gregsell/Dieter_PEV_Simulator/README.md

# dieter for EVerest PEV simulator
The EVerest PEV Simulator project documentation is split in two repositories:
1. the EVerest software running on linux, available at [gregsell/DieterEvDriver](https://github.com/gregsell/DieterEvDriver/)
2. this repo: electronics and firmware of the "Dieter" handling low level communication - *" Device Interface ElecTronic Especially not limited to Raspberry"*

demo: https://youtu.be/5YWvrdBq7K8?si=sz70jL9PTbtog_6K  
An essay covering the whole project is available under [gregsell/DieterEvDriver/docs/](https://github.com/gregsell/DieterEvDriver/) in english and german.  

## Hardware and Firmware for the Dieter PEV Simulator Board

This board is a physical interface between the [EVerest PEV Simulator](https://github.com/gregsell/DieterEvDriver/) software running on linux and a real CCS charging station. It generates and measures the IEC 61851 Control Pilot (CP) signal, drives the contactor and plug lock, and measures current and voltage on the HV lines.
The board is designed for DC charging test setups and capable of handling very high voltages.

The name and concept come from [uhi22/dieter](https://github.com/uhi22/dieter), a hardware design by Uwe Hennig. That project uses [pyPLC](https://github.com/uhi22/pyPLC) as simulation software. This repository adapts the hardware and uses an [EVerest](https://everest.github.io)-based software stack, which takes over the protocol logic from pyPLC.

## System Overview

hadware overview

## Hardware Components

The Arduino handles all low-level I/O relevant for CCS communication:

- **CP PWM measurement**: Fixed 5% duty cycle at 1 kHz (per IEC 61851-1) signals switch to high level communication by the EVSE
- **CP state control**: Sets CP voltage level to signal current state to EVSE during low-level communication
- **Contactor control**: Closes/opens the DC contactors on command from EVerest
- **Connector lock actuator**: Engages/releases the mechanical connector lock
- **Power meter**: Measures HV voltage and current

The Arduino communicates with the linux host over UART via USB using a simple text-based protocol, as implemented in the [`DieterEvDriver`](https://github.com/gregsell/DieterEvDriver/tree/main/modules/DieterEvDriver) EVerest module.
All the logic runs on the linux host. This board simply executes its commands and reads back measurements.

### HomePlug PLC Modem

In this project a patched TPlink TL-PA4010P v5.0 used (chipset: AR7420). (In the pyPLC project several modems were tested, see https://github.com/uhi22/pyPLC/blob/master/doc/hardware.md) The necessary modification steps are available there as well.   

The modem connects to the CP line and handles the high-level communication necessary for CCS. The Linux host runs `EvSlac` (EVerest module) for SLAC matching and PyEvJosev for the V2G ISO 15118-2 session over PLC.

## Arduino Serial Protocol
The Arduino exposes a simple newline-delimited text protocol over serial. The `DieterEvDriver` EVerest module running on the linux host speaks this protocol.
```
commands (host -> MCU)
  keys                   possible values            
  set_contactor             {0, 1}                            
  set_connector_lock        {0, 1}   
  set_state_c               {0, 1}

measurements (MCU -> host)
  u_inlet                   {0, 1, 2...}
  current                   {0.0, 1.0, 2.0,..}
  cp_duty_cycle             {0, 1, ..99, 100}
  connector_lock_confirmed  {0, 1}

each newline-terminated and separated by colon.

examples:
  "set_contactor:0\n"
  "u_inlet:800\n"
```
**Notes:**
- `current` is the only `float`, all the others are `integer`
- `set_state_c` might be misleading. In general there are more states, but this is the only one the EV can signal. (B <-> C)
- EVerest itself does not need current and voltage measurements

## Mounting
Mounting everything to a DIN rail (german "Hutschiene") makes it possible to use stock parts and be flexible with arrangement.

For the single PCBs adaptors were 3d printed to work with this design: https://www.printables.com/model/161740-din-rail-clip  
The source files are available under [/docs/mounting]().

Each clip can hold up to three M3 nuts spaced 9 mm apart and can be attached (and removed!) from the rail with a screwdriver. 

---

## Related Projects and useful links

- [uhi22/dieter](https://github.com/uhi22/dieter) — Original "Dieter" hardware firmware
- [uhi22/pyPLC](https://github.com/uhi22/pyPLC) — Python PLC/V2G stack, first open-source CCS implementation, also the hardware of the original "Dieter"
- [uhi22/foccci](https://github.com/uhi22/foccci) — open-source CCS controller, developed by openinverter community, runs a port of pyPLC
- [discussion on openinverter](https://openinverter.org/forum/viewtopic.php?p=37085) — homeplug investigations, beginnings of pyPLC
- [EVerest](https://github.com/EVerest/everest-core) — EV charging framework
- [charIn CCS design guide](https://www.charin.global/media/pages/technology/ccs-specification/c07034e41e-1626949173/design_guide_combined_charging_system_v7.pdf) — very useful. (Almost) everything you ever need to know about CCS
- [open-plc-utils](https://github.com/qca/open-plc-utils) — toolkit for patching PLC modem
