gregsell/Dieter_PEV_Simulator/docs/mounting/Dieter_box_DIN_rail_adapter.step

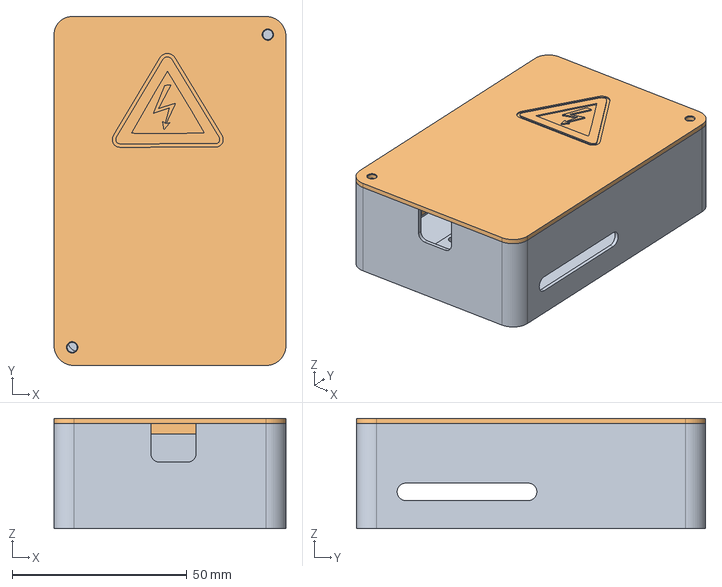
[picture p1: CAD file, 2026-06-02]
docs/mounting/Dieter_box_DIN_rail_adapter.step
66.4 x 99.9 x 31.5 mm
adapter
lid
