gregsell/Dieter_PEV_Simulator/docs/mounting/L298N_board_DIN_rail_adapter.step

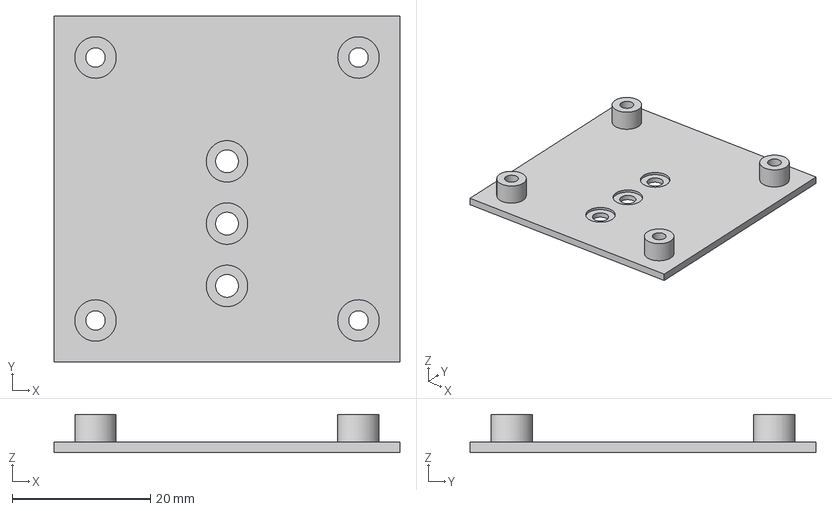
[picture p2: CAD file, 2026-06-02]
docs/mounting/L298N_board_DIN_rail_adapter.step
50.0 x 50.0 x 5.50 mm
