gregsell/Dieter_PEV_Simulator/docs/mounting/TL-PA4010P_v5.0_homeplug_adapter.step

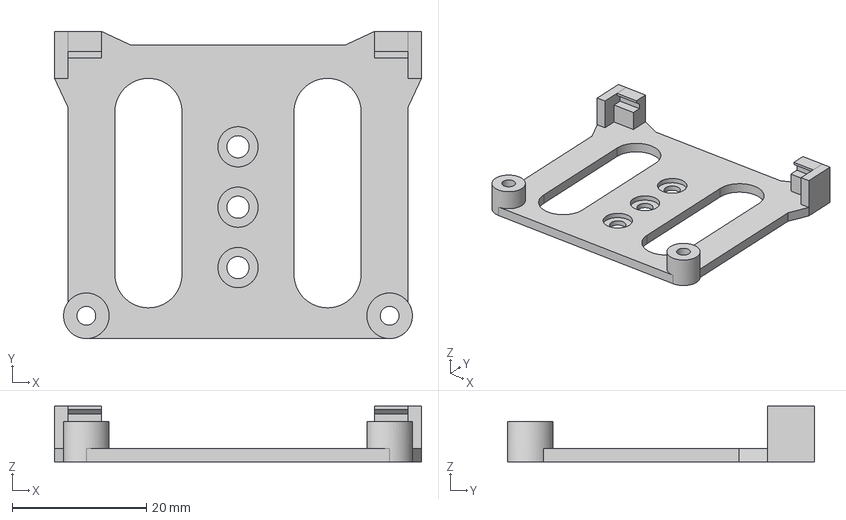
[picture p3: CAD file, 2026-06-02]
docs/mounting/TL-PA4010P_v5.0_homeplug_adapter.step
54.7 x 45.8 x 8.30 mm
