gregsell/Dieter_PEV_Simulator/docs/pcb/Dieter_PEV_Simulator_schematic.pdf

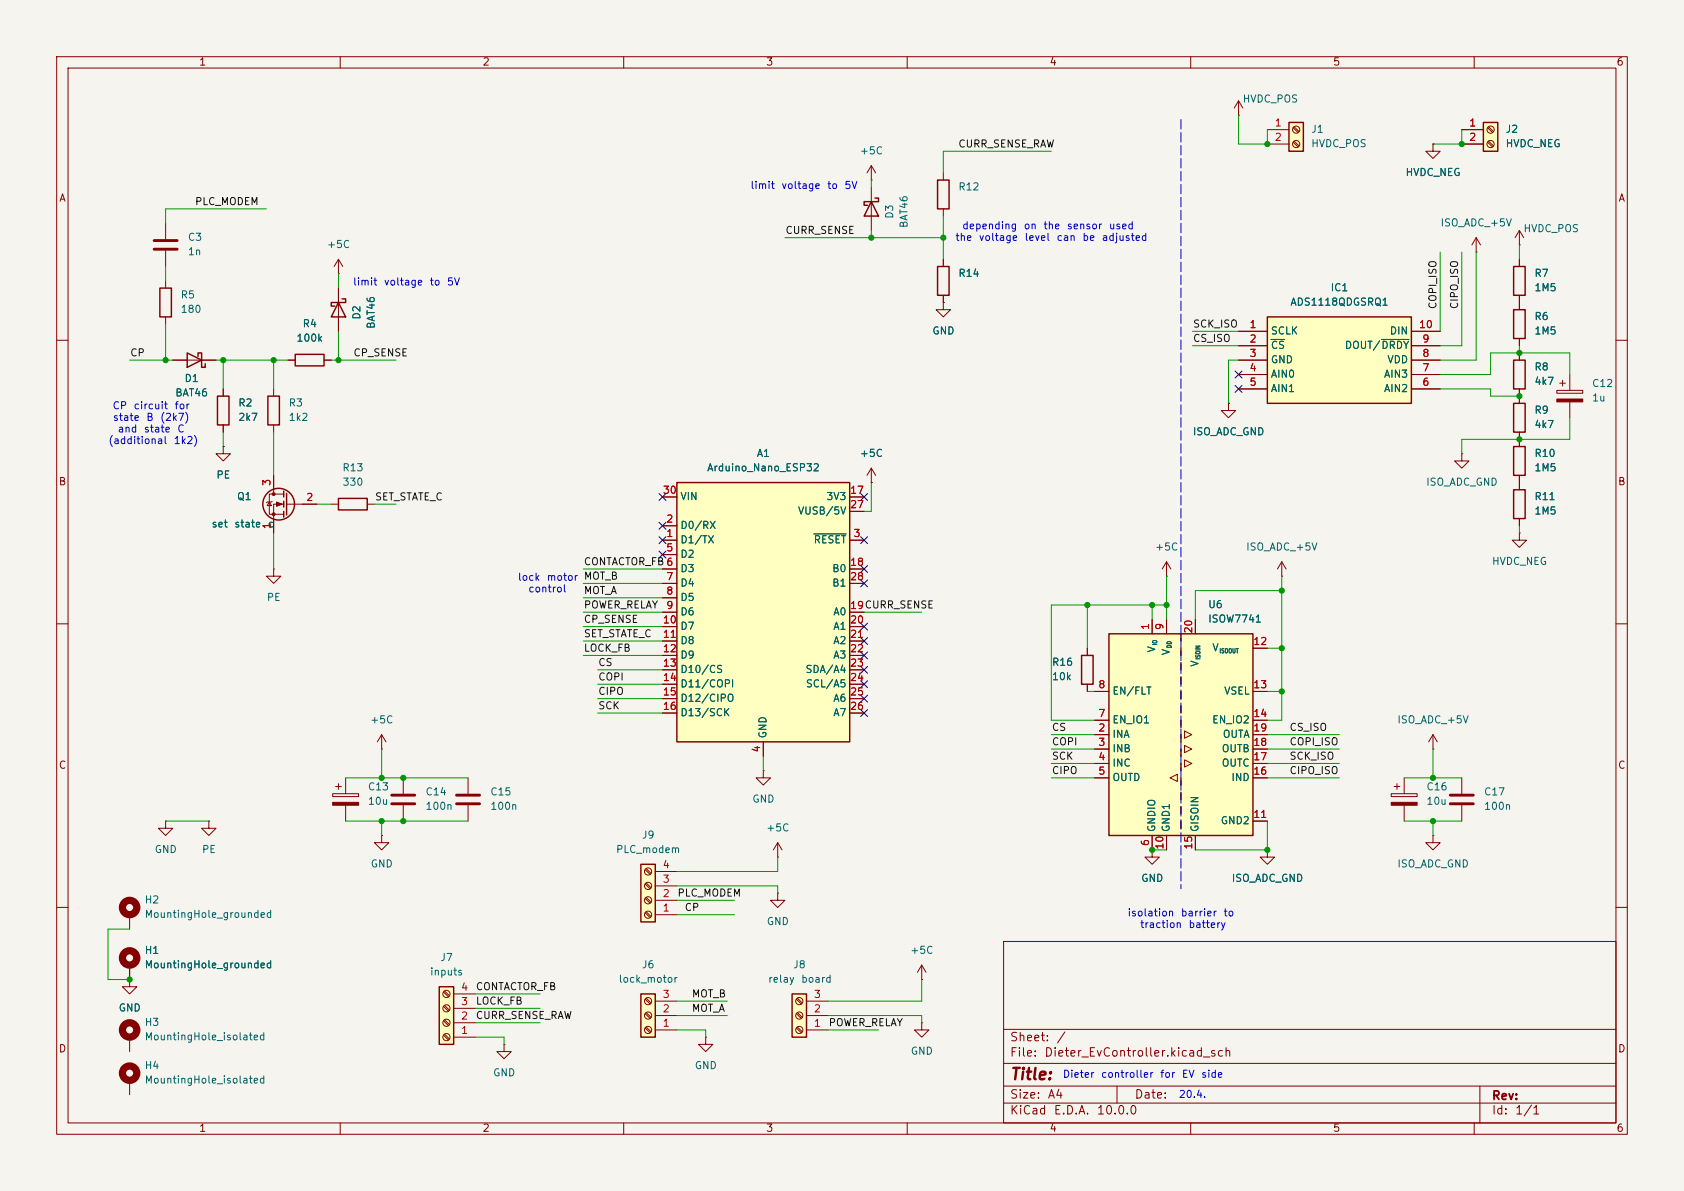
[picture p4: page 1]

depending on the sensor used
the voltage level can be adjusted

4 D2 5 D3 6 D4 7 D5 8 D6 9 D7 10 D8 11 D9 12 D10/CS 13 D11/COPI 14 D12/CIPO 15 D13/SCK 16

Dieter controller for EV side 20.4.

Size: A4 | Rev:
KiCad E.D.A. 10.0.0 | Id: 1/1
