gregsell/Dieter_PEV_Simulator/docs/pcb/Dieter_EvController.kicad_pcb

## KiCad design docs/pcb/Dieter_EvController.kicad_pcb (2026-06-02)

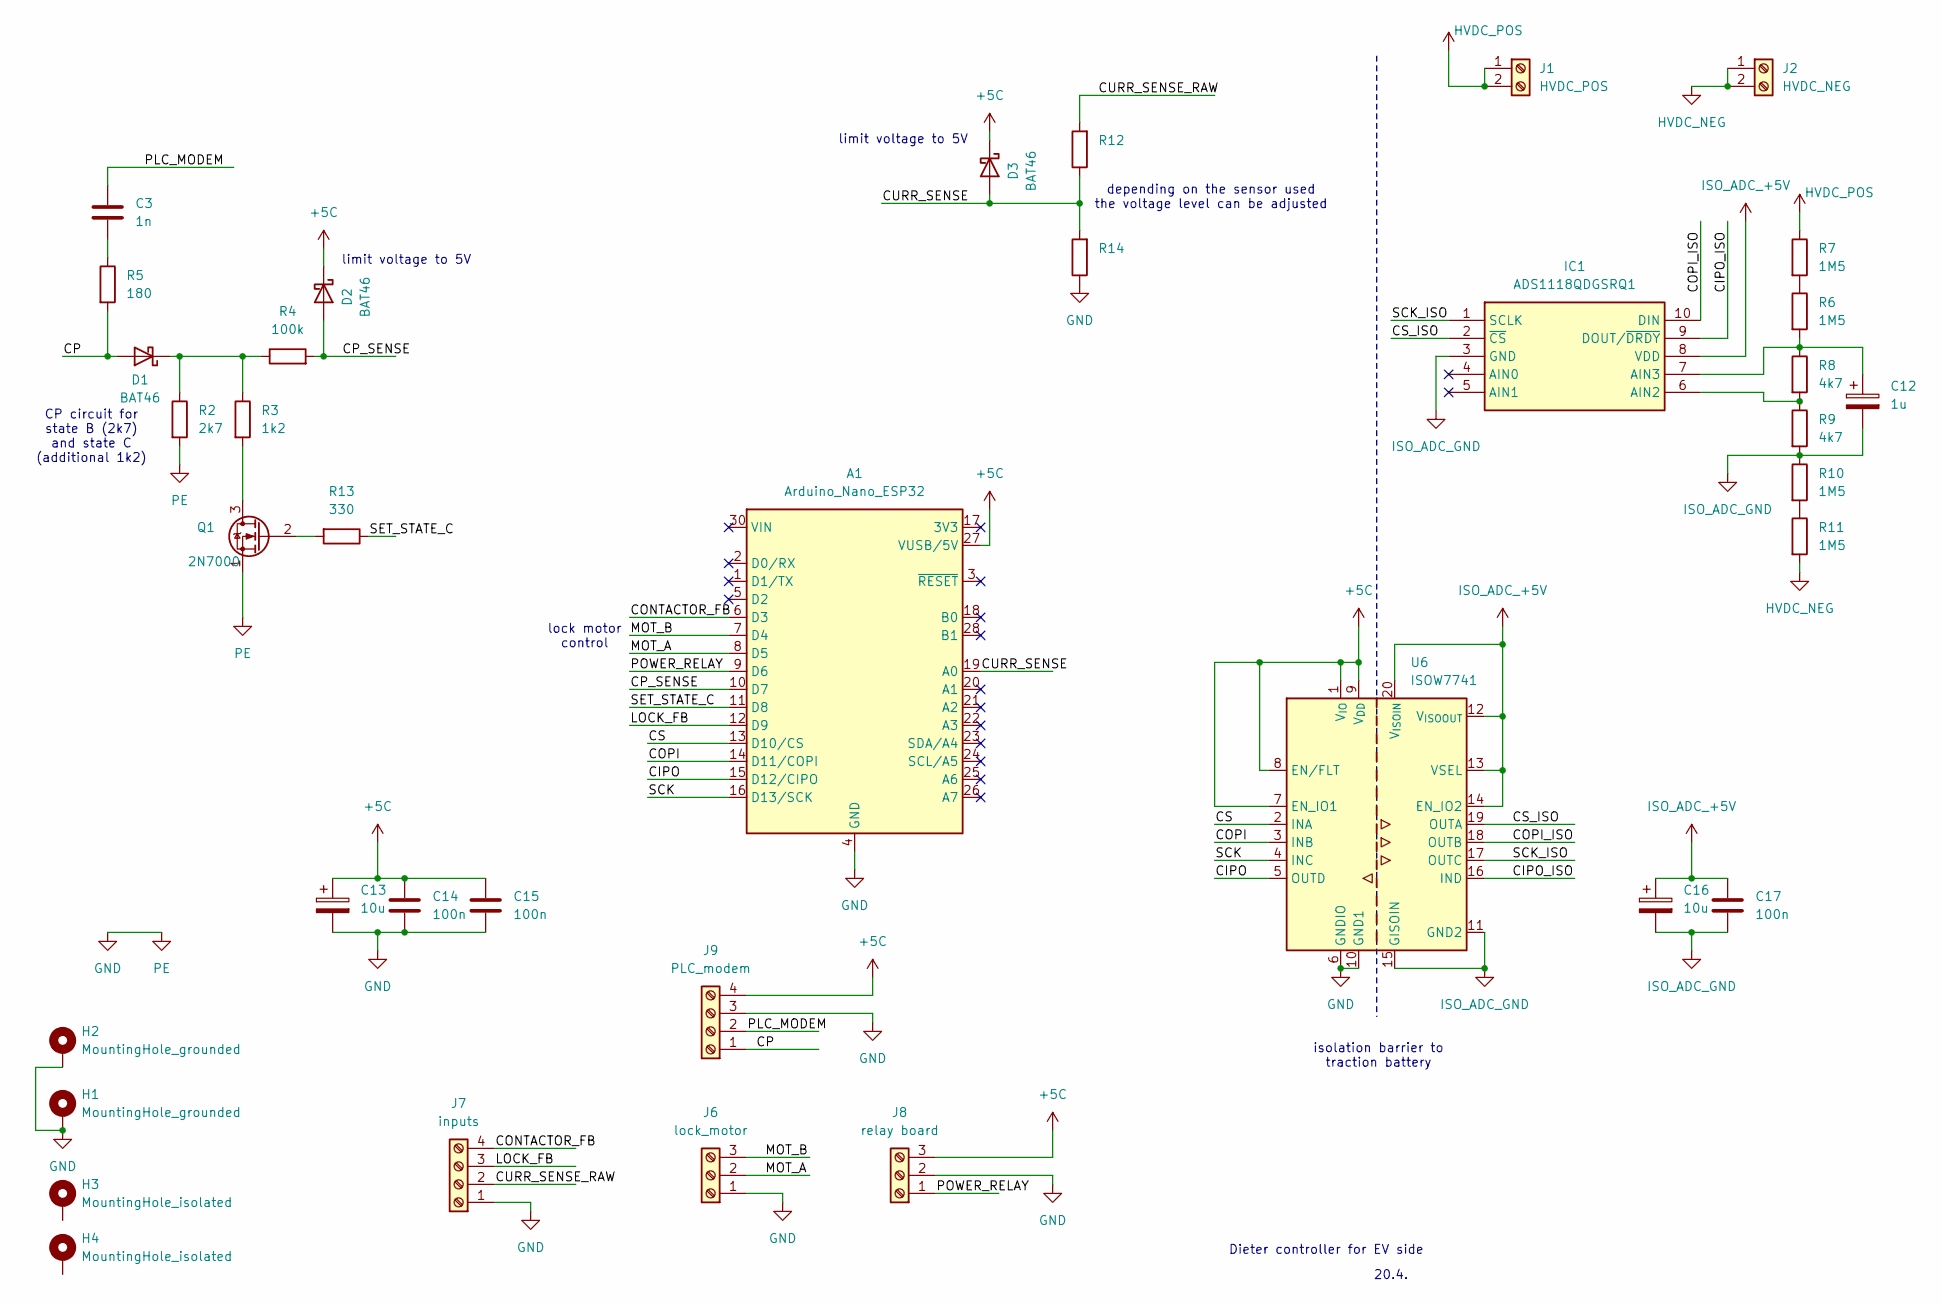
[picture p5: schematic Dieter_EvController.kicad_sch]

Parts:
A1: Arduino_Nano_ESP32; Arduino_Nano
C3: 1n; C_Disc_D5.0mm_W2.5mm_P5.00mm
C12: 1u; CP_Radial_D5.0mm_P2.00mm
C13, C16: 10u; CP_Radial_D5.0mm_P2.00mm
C14, C15, C17: 100n; C_Disc_D5.0mm_W2.5mm_P5.00mm
D1, D2, D3: BAT46; D_DO-35_SOD27_P7.62mm_Horizontal
H1, H2: MountingHole_grounded; MountingHole_3.2mm_M3_Pad_TopBottom
H3, H4: MountingHole_isolated
IC1: ADS1118QDGSRQ1; SOP50P490X110-10N; Mouser Part Number 595-ADS1118QDGSRQ1
J1: HVDC_POS; TerminalBlock_MaiXu_MX126-5.0-02P_1x02_P5.00mm
J2: HVDC_NEG; TerminalBlock_MaiXu_MX126-5.0-02P_1x02_P5.00mm
J6: lock_motor; TerminalBlock_MaiXu_MX126-5.0-03P_1x03_P5.00mm
J7: inputs; TerminalBlock_MaiXu_MX126-5.0-04P_1x04_P5.00mm
J8: relay board; TerminalBlock_MaiXu_MX126-5.0-03P_1x03_P5.00mm
J9: PLC_modem; TerminalBlock_MaiXu_MX126-5.0-04P_1x04_P5.00mm
Q1: 2N7000; TO-92_Inline
R2: 2k7; R_Axial_DIN0204_L3.6mm_D1.6mm_P7.62mm_Horizontal
R3: 1k2; R_Axial_DIN0204_L3.6mm_D1.6mm_P7.62mm_Horizontal
R4, R12, R14: 100k; R_Axial_DIN0204_L3.6mm_D1.6mm_P7.62mm_Horizontal
R5: 180; R_Axial_DIN0204_L3.6mm_D1.6mm_P7.62mm_Horizontal
R6, R7, R10, R11: 1M5; R_Axial_DIN0204_L3.6mm_D1.6mm_P7.62mm_Horizontal
R8, R9: 4k7; R_Axial_DIN0204_L3.6mm_D1.6mm_P7.62mm_Horizontal
R13: 330; R_Axial_DIN0204_L3.6mm_D1.6mm_P7.62mm_Horizontal
U6: ISOW7741; SOIC-20W_7.5x12.8mm_P1.27mm

Connections:
+5C: A1.27 (VUSB/5V), C13.1, C14.1, C15.1, D2.1 (K), D3.1 (K), J8.3, J9.4, U6.1 (V_{IO}), U6.7 (EN_IO1), U6.8 (EN/FLT), U6.9 (V_{DD})
/CIPO: A1.15 (D12/CIPO), U6.5 (OUTD)
/CIPO_ISO: IC1.9 (DOUT/~DRDY), U6.16 (IND)
/CONTACTOR_FB: A1.6 (D3), J7.4
/COPI: A1.14 (D11/COPI), U6.3 (INB)
/COPI_ISO: IC1.10 (DIN), U6.18 (OUTB)
/CP: D1.2 (A), J9.1, R5.2
/CP_SENSE: A1.10 (D7), D2.2 (A), R4.2
/CS: A1.13 (D10/CS), U6.2 (INA)
/CS_ISO: IC1.2 (~CS), U6.19 (OUTA)
/CURR_SENSE: A1.19 (A0), D3.2 (A), R12.1, R14.2
/CURR_SENSE_RAW: J7.2, R12.2
/LOCK_FB: A1.12 (D9), J7.3
/MOT_A: A1.8 (D5), J6.2
/MOT_B: A1.7 (D4), J6.3
/PLC_MODEM: C3.1, J9.2
/POWER_RELAY: A1.9 (D6), J8.1
/SCK: A1.16 (D13/SCK), U6.4 (INC)
/SCK_ISO: IC1.1 (SCLK), U6.17 (OUTC)
/SET_STATE_C: A1.11 (D8), R13.1
GND: A1.4 (GND), A1.29 (GND), C13.2, C14.2, C15.2, H1.1 (1_1), H2.1 (1_1), J6.1, J7.1, J8.2, J9.3, Q1.1 (S), R2.2, R14.1, U6.6 (GNDIO), U6.10 (GND1)
HVDC_NEG: J2.1, J2.2, R11.2
HVDC_POS: J1.1, J1.2, R7.1
ISO_ADC_+5V: C16.1, C17.1, IC1.8 (VDD), U6.12 (V_{ISOOUT}), U6.13 (VSEL), U6.14 (EN_IO2), U6.20 (V_{ISOIN})
ISO_ADC_GND: C12.2, C16.2, C17.2, IC1.3 (GND), R9.2, R10.1, U6.11 (GND2), U6.15 (GISOIN)
unnamed: C3.2, R5.1
unnamed: D1.1 (K), R2.1, R3.1, R4.1
unnamed: IC1.6 (AIN2), R8.2, R9.1
unnamed: C12.1, IC1.7 (AIN3), R6.2, R8.1
unnamed: Q1.3 (D), R3.2
unnamed: Q1.2 (G), R13.2
unnamed: R6.1, R7.2
unnamed: R10.2, R11.1

Notes on the sheet:
CP circuit for state B (2k7) and state C (additional 1k2)
20.4.
depending on the sensor used the voltage level can be adjusted
limit voltage to 5V
lock motor control
Dieter controller for EV side
isolation barrier to traction battery

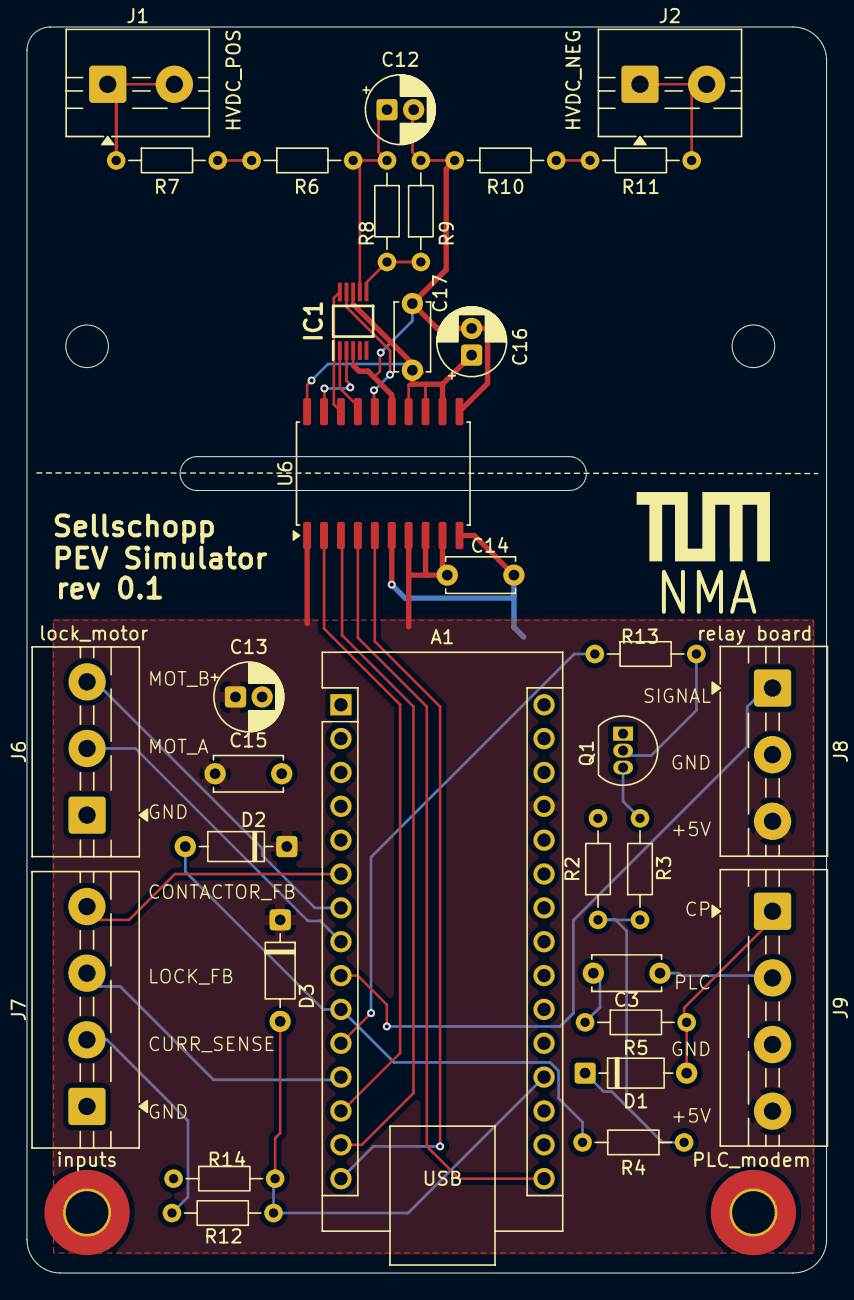
[picture p6: board Dieter_EvController.kicad_pcb from above]

Board: 2 copper layers, 60.0 x 93.5 mm, 35 parts (0 on the bottom side), 33 nets.
