gregsell/Dieter_PEV_Simulator/src/main.cpp

/*
description of protocol DieterEvDriver <-> Dieter:

commands (host -> MCU)
  keys                   possible values            
  set_contactor             {0, 1}                            
  set_connector_lock        {0, 1}   
  set_state_c               {0, 1}

measurements (MCU -> host)
  u_inlet                   {0, 1, 2...}
  current                   {0.0, 1.0, 2.0,..}
  cp_duty_cycle             {0, 1, ..99, 100}
  connector_lock_confirmed  {0, 1}

each newline-terminated and separated by colon.

examples:
  "set_contactor:0\n"
  "set_cp_state:C\n"
  "u_inlet:800\n"
*/

#include <Arduino.h>
#include <SPI.h>
#include <ADS1118.h>


# define PIN_CURR_SENSE A0
// resistances of voltge divider; refer to schematic
# define CURR_SENSE_R14 4700
# define CURR_SENSE_R12 4700

# define PIN_CP_DUTY_CYCLE_INPUT 7
# define PIN_CONNECTOR_LOCK_FB 9

# define PIN_POWER_RELAY_OUTPUT 6
# define PIN_POWER_RELAY_FB 3
# define PIN_CP_MOSFET_OUTPUT 8

# define PIN_MOTOR_DRIVER_A 4
# define PIN_MOTOR_DRIVER_B 5
// chip select for SPI comm with ADS
# define PIN_CS_ADS1118 10

ADS1118 ads1118(PIN_CS_ADS1118);


const unsigned long PUBLISH_INTERVAL_MS = 500;

const unsigned long LOCK_TIMEOUT_MS = 400; // time-based control (not current) of connector lock motor

const int N_AVERAGE = 10;   // averaging over several read input values

const int LINE_MAX = 42;    // top limit for UART msg length
char in_line[LINE_MAX];     // input line buffer
int in_len = 0;             // current length of buffer

// states of lock motor
enum class LockState {
  IDLE,
  LOCKING,
  UNLOCKING
};
// keep track of what lock motor is doing
LockState lock_state = LockState::IDLE;

unsigned long t_last_publish = 0;
unsigned long lock_timer_start = 0;

int u_inlet;                // DC voltage measured at HV connect, before relays
float current;              // DC current on HV lines
int cp_duty_cycle;          // duty cycle of C_p line
int connector_lock_confirmed = 0;// feedback switch status from CCS connector lock

// read CCS inlet voltage by reading values from external ADC via SPI
void readInletVoltage() {
  float tmp = 0;
  // averaging ADC readings
  for (int i = 0; i < N_AVERAGE; i++) {
    //tmp += map(analogRead(PIN_U_INLET_INPUT), 0, 1023 , 0, 1000); // dummy test value, later read from ext ADC
    tmp += ads1118.getMilliVolts();
  }
  u_inlet = (int) tmp / N_AVERAGE;
  // later do SPI/I2C stuff here
}

// measure current from clamp sensor
void readCurrent() {
  int raw = analogRead(PIN_CURR_SENSE);
  // 10 bit ADC resolution; remap to 5V range and scale according to resistor divider
  current = raw * 5.0 / 1023 * CURR_SENSE_R12 / (CURR_SENSE_R12 + CURR_SENSE_R14);
}

// measure PWM duty cycle of CP line 
void readCpDutyCycle() {
  // three cases to distinguish: logic high, logic low, or 1 kHz PWM
  unsigned long t = pulseIn(PIN_CP_DUTY_CYCLE_INPUT, HIGH, 3000); // use pulseIn timeout of 3 ms to rule out PWM
  if (t == 0) {
    // constant voltage on cp, as timeout was triggered
    if (digitalRead(PIN_CP_DUTY_CYCLE_INPUT)) cp_duty_cycle = 100; // logic high is treated as duty cycle = 100% 
    else cp_duty_cycle = 0;                                            // logic low is treated as duty cycle = 0%
  }
  else { // else there is a "true" PWM
    float tmp = 0;
    // averaging PWM
    int counter = N_AVERAGE;
    for (int i = 0; i < counter; i++) {
      int raw = pulseIn(PIN_CP_DUTY_CYCLE_INPUT, HIGH, 2000);
      if (raw == 0) counter--; // in case of timeout the reading is omitted       <------- REMOVE?
      tmp += raw;
    }
    if (tmp == 0) { // If the sum ist still zero, there is an error
      Serial.println("error: invalid cp duty cycle reading");
      cp_duty_cycle = -1; 
      return;
    }
    // one period is 1 ms => 50 % duty cycle: 500 us => additional division by ten
    cp_duty_cycle = (int) tmp / (counter * 10);
  }
}

// read in the state of the microswitch inside the CCS inlet locking actuator 
void readConnLockFB() {
  // internal pullup resistor
  // for now assume low-side closing switch
  connector_lock_confirmed = digitalRead(PIN_CONNECTOR_LOCK_FB)==HIGH ? 1 : 0;
}

// publish all measurements via UART
void publishMeasurements() {
  // schema:
  // key:value\n
  char s[30];
  sprintf(s, "u_inlet:%d", u_inlet);  
  Serial.println(s);
  char tmp[6];  
  dtostrf( current, 4, 2, tmp);    // arduino boards can't do sprintf with %f
  sprintf(s, "current:%s", tmp);  
  Serial.println(s);
  sprintf(s, "cp_duty_cycle:%d", cp_duty_cycle);
  Serial.println(s);
  sprintf(s, "connector_lock_confirmed:%d", connector_lock_confirmed);
  Serial.println(s);
}

// process single received line 
void process_line(const char *line) {
  char* separator = strchr(line, ':');
  if (separator == nullptr) {
    Serial.println("invalid syntax");
    return; // found no ':'
  }
  // extract key
  int keyLen = separator - line; // key length by substracting memory adresses
  char key[32];
  strncpy(key, line, keyLen);
  key[keyLen] = '\0'; // zero termination

  char* value = separator + 1;
  // Serial.print("found key: "); Serial.print(key); Serial.print(" and value: "); Serial.println(value);

  if (strcmp(key, "set_contactor") == 0) {
    int cmd = atoi(value);
    if (cmd == 1 || cmd == 0)  {
      digitalWrite(PIN_POWER_RELAY_OUTPUT, (cmd==1) ? LOW : HIGH);
    }
    
    // for testing small 5V relais were used.
    // when proper contactors are used the auxiliary switch should be read in to rule out welded contacts
    // the reserved pin is PIN_POWER_RELAY_FB
  } 
  else if (strcmp(key, "set_connector_lock") == 0) {
    int cmd = atoi(value);
    if (cmd == 1 || cmd == 0) {
      // drive differential pins of L298N input
      // (enable of L298N is pulled high => always max speed)
      digitalWrite(PIN_MOTOR_DRIVER_A, !cmd);
      digitalWrite(PIN_MOTOR_DRIVER_B, cmd);
      lock_state = cmd==1 ? LockState::LOCKING : LockState::UNLOCKING; 
      lock_timer_start = millis();
    }
  }
  else if (strcmp(key, "set_state_c") == 0) {
    int cmd = atoi(value);
    if (cmd == 1 || cmd == 0) digitalWrite(PIN_CP_MOSFET_OUTPUT, cmd);
    }
  else Serial.println("unknown command");
  // else unknown command
}

// the CCS connector lock actuator does not lock instantly.
// This method is called periodically to check if a change of control signals is necessary
void connector_lock_task() {
  if (millis() - lock_timer_start >= LOCK_TIMEOUT_MS) {
    // set both inputs equal, this stops motor (see L298 datasheet)
    digitalWrite(PIN_MOTOR_DRIVER_A, LOW);
    digitalWrite(PIN_MOTOR_DRIVER_B, LOW);
    readConnLockFB();
    lock_state = LockState::IDLE;
  }
}

// periodic check of serial interface
void serial_rx_task() {
  while (Serial.available() > 0) {
    char c = (char)Serial.read();
    if (c == '\r') continue;        // ignore CR
    if (c == '\n') {                // every msg is newline terminated
      if (in_len > 0) {
        in_line[in_len] = '\0';     // get rid of the newline char
        process_line(in_line);
        in_len = 0;
      }
    } else {
      if (in_len + 1 < LINE_MAX) {
        in_line[in_len++] = c;
      } else {
        // overflow → reset line
        in_len = 0;
      }
    }
  }
}

void dummyValues(){
  u_inlet = 400;
  cp_duty_cycle = 5;
  connector_lock_confirmed = 1;
  current = 42;
}

void setup() {
  pinMode(PIN_POWER_RELAY_OUTPUT, OUTPUT);
  pinMode(PIN_CP_MOSFET_OUTPUT, OUTPUT);
  pinMode(PIN_MOTOR_DRIVER_A, OUTPUT);
  pinMode(PIN_MOTOR_DRIVER_B, OUTPUT);

  digitalWrite(PIN_POWER_RELAY_OUTPUT, HIGH); // active low
  digitalWrite(PIN_CP_MOSFET_OUTPUT,LOW);

  pinMode(PIN_CONNECTOR_LOCK_FB, INPUT_PULLUP);
  pinMode(PIN_CP_DUTY_CYCLE_INPUT, INPUT);

  analogReference(INTERNAL);

  Serial.begin(19200);
  
  /* Changing the sampling rate. RATE_8SPS, RATE_16SPS, RATE_32SPS, RATE_64SPS, RATE_128SPS, RATE_250SPS, RATE_475SPS, RATE_860SPS*/
  ads1118.setSamplingRate(ads1118.RATE_16SPS);
  /* Changing the input selected. Differential inputs: DIFF_0_1, DIFF_0_3, DIFF_1_3, DIFF_2_3. Single ended input: AIN_0, AIN_1, AIN_2, AIN_3*/
  ads1118.setInputSelected(ads1118.AIN_3);
  /* Changing the full scale range. 
    *  FSR_6144 (±6.144V)*, FSR_4096(±4.096V)*, FSR_2048(±2.048V), FSR_1024(±1.024V), FSR_0512(±0.512V), FSR_0256(±0.256V).
    *  (*) No more than VDD + 0.3 V must be applied to this device. 
    */
  ads1118.setFullScaleRange(ads1118.FSR_6144);
  Serial.println("ads setup done");
  //Serial.println(String(ads1118.getTemperature(),6)+" C"); //Getting temperature of the internal sensor
}

void loop() {

  //readInletVoltage();
  readCurrent();
  readCpDutyCycle();
  readConnLockFB();

  //dummyValues();
  
  serial_rx_task();
  connector_lock_task();
  
  if ((millis() - t_last_publish)>PUBLISH_INTERVAL_MS) {
    t_last_publish = millis();
    publishMeasurements();
  }
}
