gregsell/Dieter_PEV_Simulator/(commit log)

2026-04-11 parse measurements: high voltage (not complete yet) Cp pin duty cycle feedback from CCS connector lock
    handles the following commands
    set Cp state
    set connector lock state (not complete yet)
    set contactor state
    add documentation to protocol
2026-04-12 fix: drop transmit of cp state, control by bool set_state_c now
    [main.cpp]
2026-04-14 fix: cmd string to int conversion
    [main.cpp]
2026-05-05 refractor: change name to connector_lock_confirmed
2026-05-05 feat: lock motor control
2026-05-10 chore: update PINs according to schematic
2026-05-22 add external ADC + current readout
2026-05-22 chore: add electronics docs
    [Dieter_PEV_Simulator.kicad_pcb, Dieter_PEV_Simulator.kicad_sch]
2026-05-22 chore: remove compile_commands from gitignore, delete empty folders documentation: fancy README, pcb + mounting source files
2026-06-02 feat: connector lock works
2026-06-02 documentation: add mounting + corrected pcb source files; BOM
    [Dieter_EvController.kicad_pcb, Dieter_EvController.kicad_sch, Dieter_PEV_Simulator.csv, Dieter_box_DIN_rail_adapter.step, L298N_board_DIN_rail_adapter.step, TL-PA4010P_v5.0_homeplug_adapter.step]
2026-09-04 refractor: correct handling of logic HIGH in digitalWrite(); not relying on undocumented behaviour
    [main.cpp]
2026-09-22 chore: remove duplicate schematic
